Elifa58/Arduino_Uno_PCB/PCB_Project.pdf

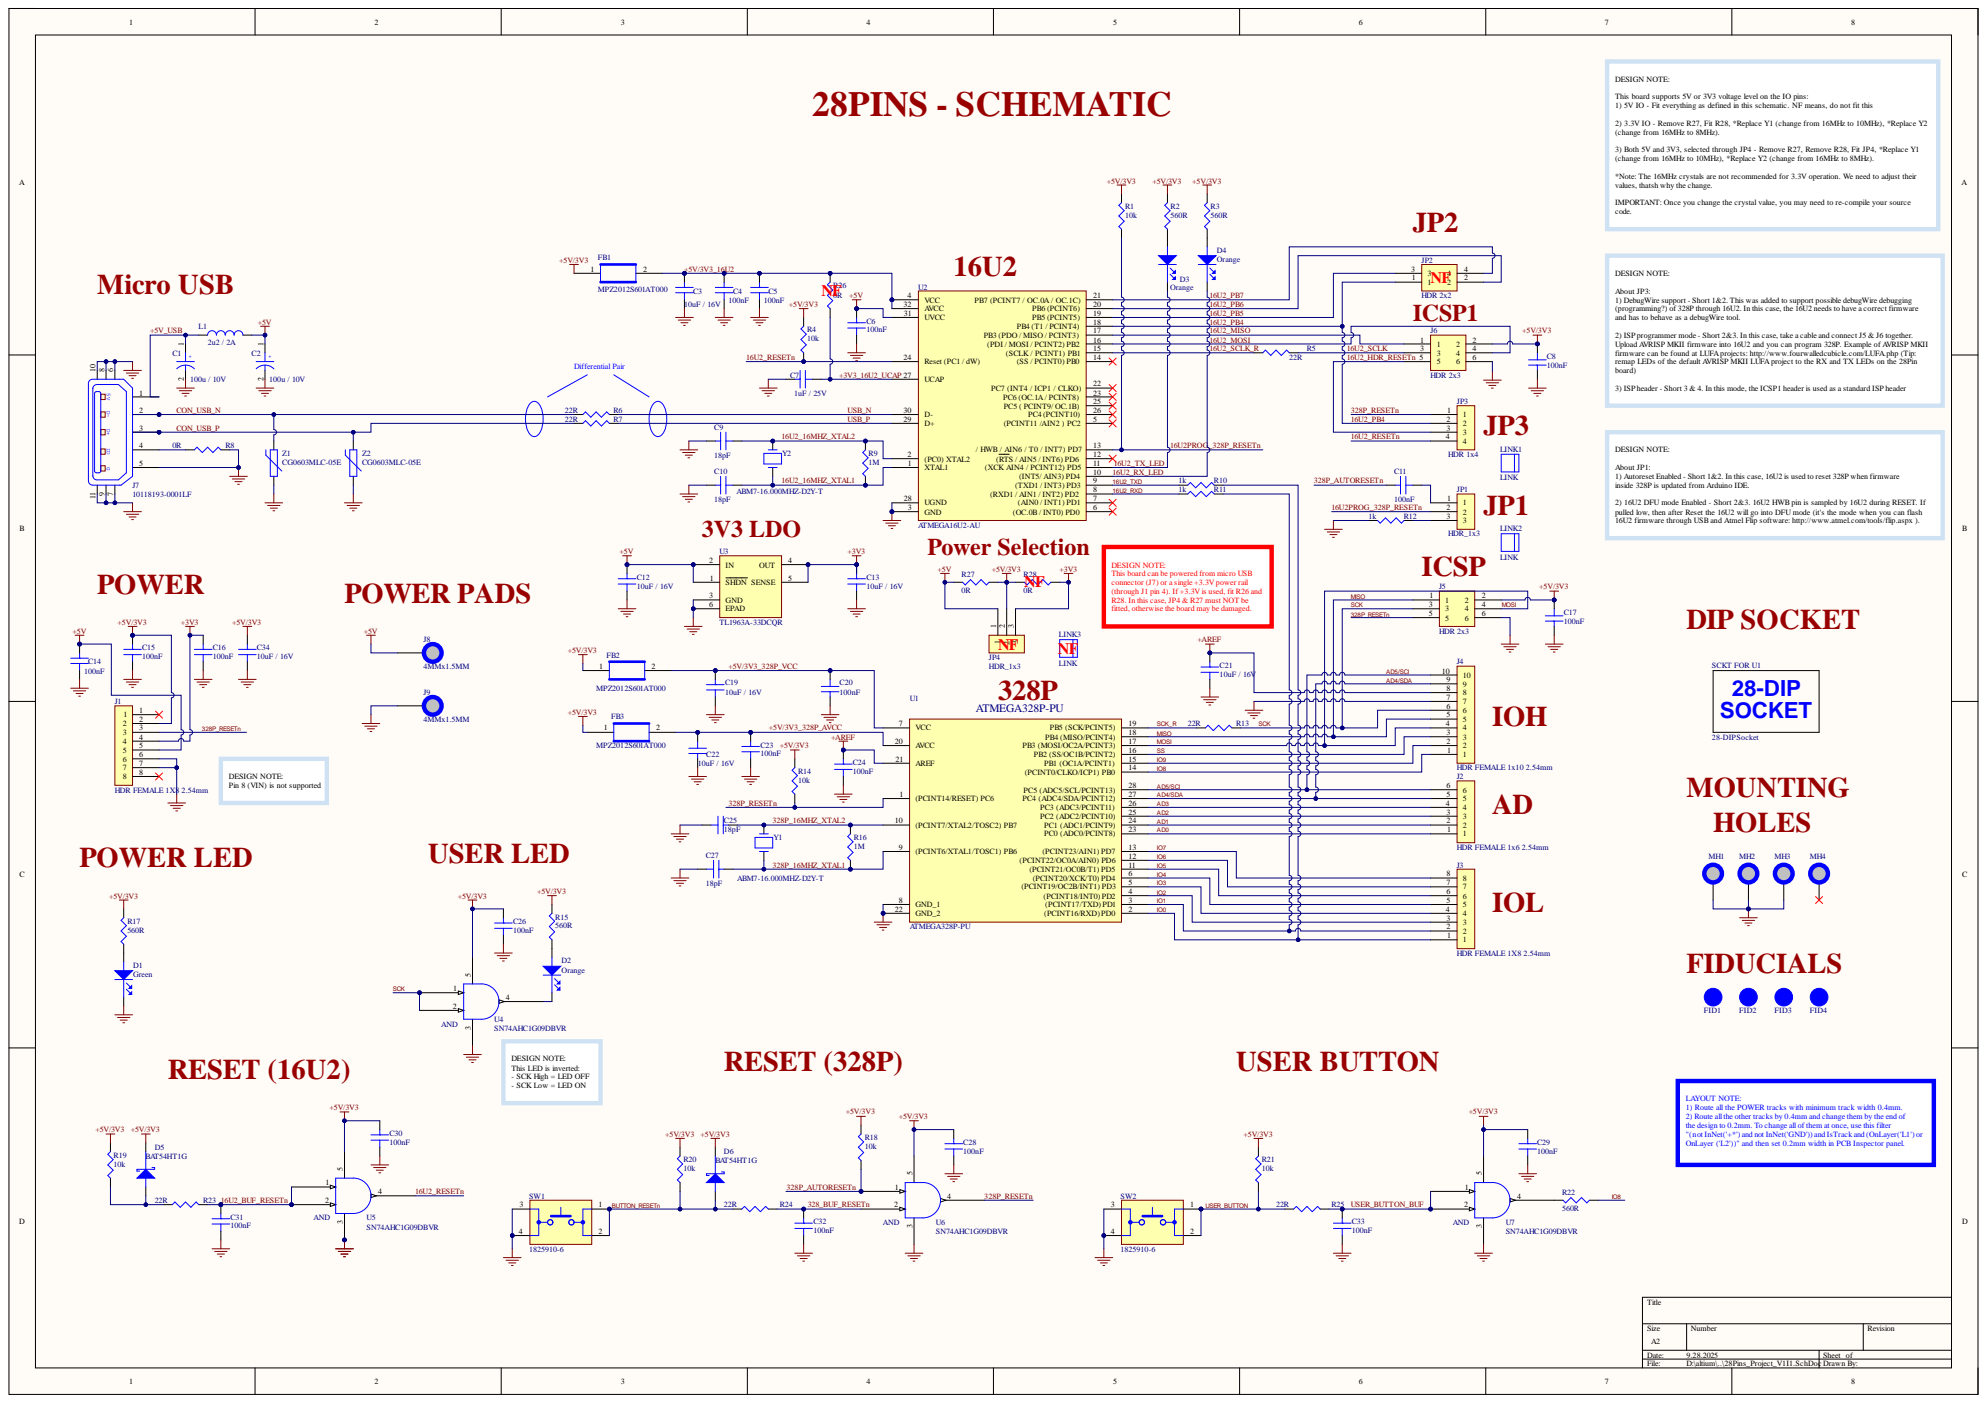
[picture p1: page 1]

This board supports 5V or 3V3 voltage level on the IO pins:
1) 5V IO - Fit everything as defined in this schematic. NF means, do not fit this

2) 3.3V IO - Remove R27, Fit R28, *Replace Y1 (change from 16MHz to 10MHz), *Replace Y2
(change from 16MHz to 8MHz).

3) Both 5V and 3V3, selected through JP4 - Remove R27, Remove R28, Fit JP4, *Replace Y1
(change from 16MHz to 10MHz), *Replace Y2 (change from 16MHz to 8MHz).

*Note: The 16MHz crystals are not recommended for 3.3V operation. We need to adjust their
values, thatsh why the change.

IMPORTANT: Once you change the crystal value, you may need to re-compile your source
code.

Orange 16U2_PB7

About JP3:
1) DebugWire support - Short 1&2. This was added to support possible debugWire debugging
(programming?) of 328P through 16U2. In this case, the 16U2 needs to have a correct firmware
and has to behave as a debugWire tool.

UVCC 31 AVCC 32 | 16U2_PB6 | ICSP1

2) ISP programmer mode - Short 2&3. In this case, take a cable and connect J5 & J6 together.
Upload AVRISP MKII firmware into 16U2 and you can program 328P. Example of AVRISP MKII
firmware can be found at LUFAprojects: http://www.fourwalledcubicle.com/LUFA.php (Tip:
remap LEDs of the default AVRISP MKII LUFAproject to the RX and TX LEDs on the 28Pin
board)

3) ISP header - Short 3 & 4. In this mode, the ICSP1 header is used as a standard ISP header

About JP1:
1) Autoreset Enabled - Short 1&2. In this case, 16U2 is used to reset 328P when firmware
inside 328P is updated from Arduino IDE.

2) 16U2 DFU mode Enabled - Short 2&3. 16U2 HWB pin is sampled by 16U2 during RESET. If
pulled low, then after Reset the 16U2 will go into DFU mode (it's the mode when you can flash
16U2 firmware through USB and Atmel Flip software: http://www.atmel.com/tools/flip.aspx ).

DESIGN NOTE:
This board can be powered from micro USB
connector (J7) or a single +3.3V power rail
(through J1 pin 4). If +3.3V is used, fit R26 and
R28. In this case, JP4 & R27 must NOT be
fitted, otherwise the board may be damaged.

Pin 8 (VIN) is not supported

(PCINT6/XTAL1/TOSC1) PB6 9 | AD0

IO5
IO4
IO3

GND_2 22 | | IO0

This LED is inverted:
- SCK High = LED OFF
- SCK Low = LED ON

LAYOUT NOTE:
1) Route all the POWER tracks with minimum track width 0.4mm.
2) Route all the other tracks by 0.4mm and change them by the end of
the design to 0.2mm. To change all of them at once, use this filter
"(not InNet('+*') and not InNet('GND')) and IsTrack and (OnLayer('L1') or
OnLayer ('L2'))" and then set 0.2mm width in PCB Inspector panel.

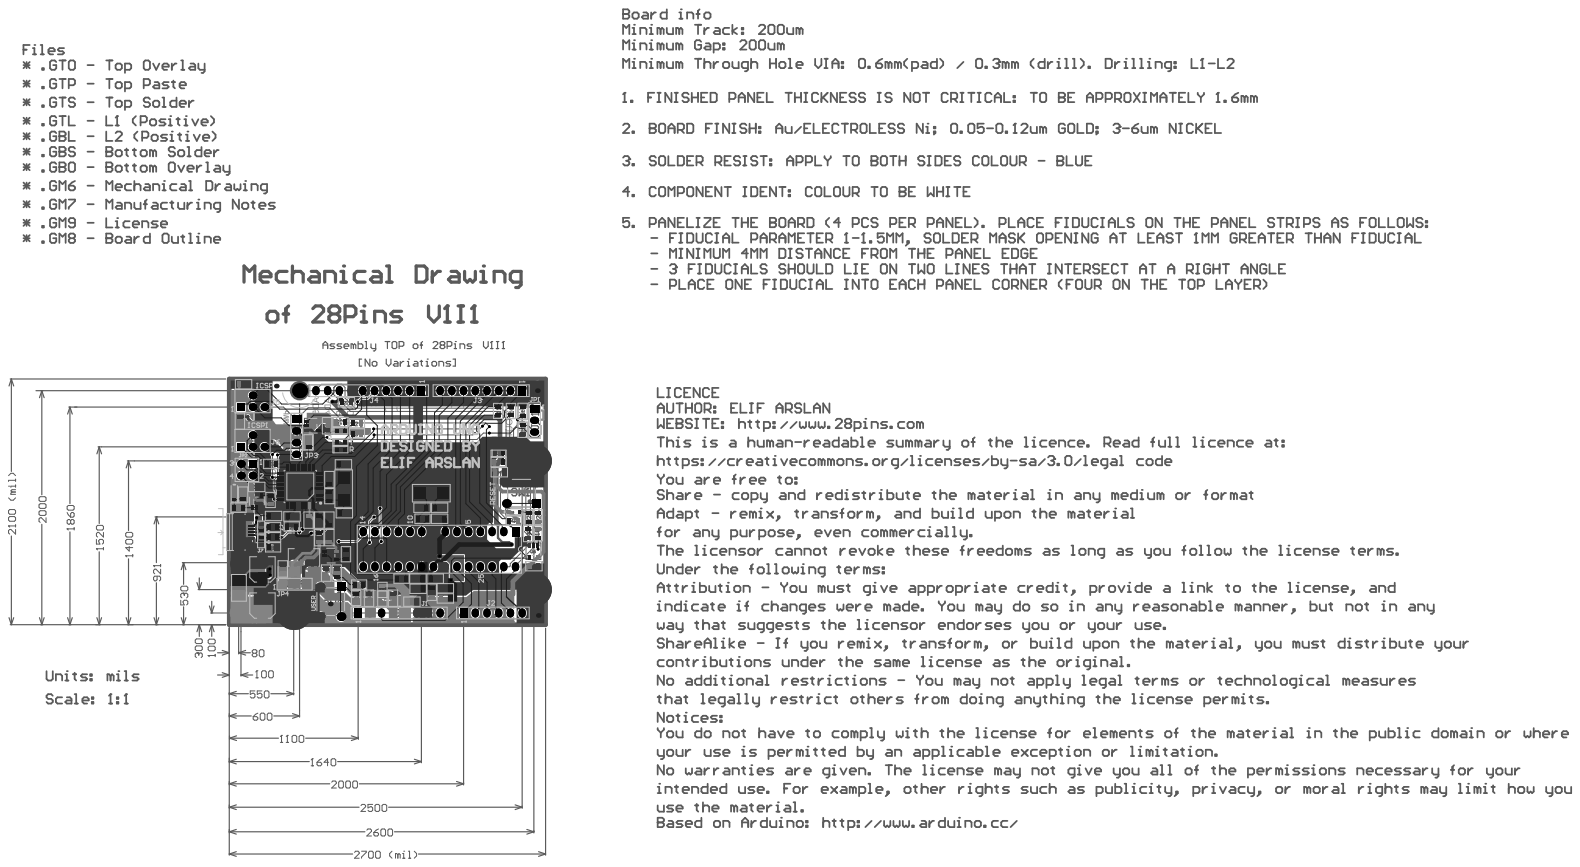
[picture p2: page 2]

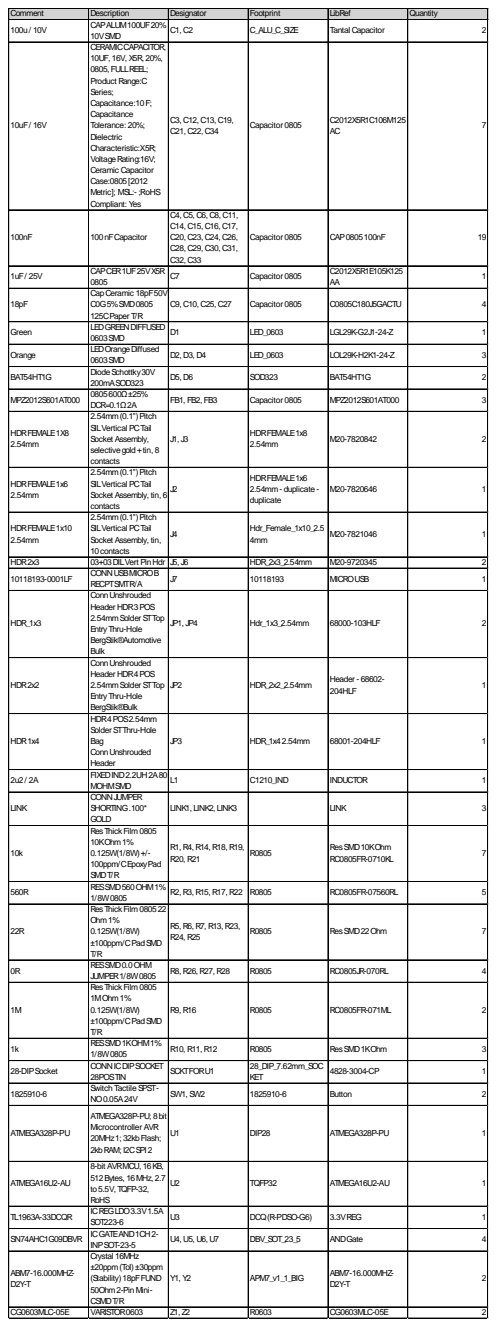
[picture p3: page 3]

Comment | Description | Designator | Footprint | LibRef | Quantity
100u/ 10V | CAPALUM100UF20% 10VSMD | C1, C2 | C_ALU_C_SIZE | Tantal Capacitor | | 2

10uF/ 16V | CERAMICCAPACITOR, 10UF, 16V, X5R, 20%, 0805, FULLREEL; Product Range:C Series; Capacitance:10F; Capacitance Tolerance: 20%; Dielectric Characteristic:X5R; VoltageRating:16V; Ceramic Capacitor Case:0805[2012 Metric]; MSL:- ;RoHS Compliant: Yes | C3, C12, C13, C19, C21, C22, C34 | Capacitor 0805 | C2012X5R1C106M125 AC | | 7

100nF | 100nFCapacitor | C4, C5, C6, C8, C11, C14, C15, C16, C17, C20, C23, C24, C26, C28, C29, C30, C31, C32, C33 | Capacitor 0805 | CAP0805100nF | 19

1uF/ 25V | CAPCER1UF25VX5R 0805 | C7 | Capacitor 0805 | C2012X5R1E105K125 AA | | 1

18pF | CapCeramic 18pF50V C0G5%SMD0805 125CPaper T/R | C9, C10, C25, C27 | Capacitor 0805 | C0805C180J5GACTU | | 4

Green | LEDGREENDIFFUSED 0603SMD | D1 | LED_0603 | LGL29K-G2J1-24-Z | | 1

Orange | LEDOrangeDiffused 0603SMD | D2, D3, D4 | LED_0603 | LOL29K-H2K1-24-Z | | 3

BAT54HT1G | DiodeSchottky30V 200mASOD323 | D5, D6 | SOD323 | BAT54HT1G | | 2

MPZ2012S601AT000 | 0805600Ω±25% DCR=0.1Ω2A | FB1, FB2, FB3 | Capacitor 0805 | MPZ2012S601AT000 | | 3

HDRFEMALE1X8 2.54mm | 2.54mm(0.1")Pitch SILVertical PCTail Socket Assembly, selectivegold+tin, 8 contacts | J1, J3 | HDRFEMALE1x8 2.54mm | M20-7820842 | | 2

HDRFEMALE1x6 2.54mm | 2.54mm(0.1")Pitch SILVertical PCTail Socket Assembly, tin, 6 contacts | J2 | HDRFEMALE1x6 2.54mm- duplicate-duplicate | M20-7820646 | | 1

HDRFEMALE1x10 2.54mm | 2.54mm(0.1")Pitch SILVertical PCTail Socket Assembly, tin, 10contacts | J4 | Hdr_Female_1x10_2.5 4mm | M20-7821046 | | 1

HDR2x3 | 03+03DILVert PinHdr | J5, J6 | HDR_2x3_2.54mm | M20-9720345 | | 2
10118193-0001LF | CONNUSBMICROB RECPTSMTR/A | J7 | 10118193 | MICROUSB | | 1

HDR_1x3 | ConnUnshrouded Header HDR3POS 2.54mmSolder STTop EntryThru-Hole BergStik®Automotive Bulk | JP1, JP4 | Hdr_1x3_2.54mm | 68000-103HLF | | 2

HDR2x2 | ConnUnshrouded Header HDR4POS 2.54mmSolder STTop EntryThru-Hole BergStik®Bulk | JP2 | HDR_2x2_2.54mm | Header - 68602-204HLF | | 1

HDR1x4 | HDR4POS2.54mm Solder STThru-Hole Bag ConnUnshrouded Header | JP3 | HDR_1x42.54mm | 68001-204HLF | | 1

2u2/ 2A | FIXEDIND2.2UH2A80 MOHMSMD | L1 | C1210_IND | INDUCTOR | | 1

LINK | CONNJUMPER SHORTING.100* GOLD | LINK1, LINK2, LINK3 | | LINK | | 3

10k | ResThickFilm 0805 10KOhm1% 0.125W(1/8W)+/-100ppm/CEpoxyPad SMDT/R | R1, R4, R14, R18, R19, R20, R21 | R0805 | ResSMD10KOhm RC0805FR-0710KL | | 7

560R | RESSMD560OHM1% 1/8W0805 | R2, R3, R15, R17, R22 | R0805 | RC0805FR-07560RL | | 5

22R | ResThickFilm 080522 Ohm1% 0.125W(1/8W) ±100ppm/CPadSMD T/R | R5, R6, R7, R13, R23, R24, R25 | R0805 | ResSMD22Ohm | | 7

0R | RESSMD0.0OHM JUMPER1/8W0805 | R8, R26, R27, R28 | R0805 | RC0805JR-070RL | | 4

1M | ResThickFilm 0805 1MOhm1% 0.125W(1/8W) ±100ppm/CPadSMD T/R | R9, R16 | R0805 | RC0805FR-071ML | | 2

1k | RESSMD1KOHM1% 1/8W0805 | R10, R11, R12 | R0805 | ResSMD1KOhm | | 3

28-DIPSocket | CONNICDIPSOCKET 28POSTIN | SCKTFORU1 | 28_DIP_7.62mm_SOC KET | 4828-3004-CP | | 1

1825910-6 | SwitchTactileSPST-NO0.05A24V | SW1, SW2 | 1825910-6 | Button | | 2

ATMEGA328P-PU | ATMEGA328P-PU; 8bit Microcontroller AVR 20MHz1; 32kbFlash; 2kbRAM; I2CSPI2 | U1 | DIP28 | ATMEGA328P-PU | | 1

ATMEGA16U2-AU | 8-bit AVRMCU, 16KB, 512Bytes, 16MHz, 2.7 to5.5V, TQFP-32, RoHS | U2 | TQFP32 | ATMEGA16U2-AU | | 1

TL1963A-33DCQR | ICREGLDO3.3V1.5A SOT223-6 | U3 | DCQ(R-PDSO-G6) | 3.3VREG | | 1

SN74AHC1G09DBVR | ICGATEAND1CH2-INPSOT-23-5 | U4, U5, U6, U7 | DBV_SOT_23_5 | ANDGate | | 4

ABM7-16.000MHZ-D2Y-T | Crystal 16MHz ±20ppm(Tol) ±30ppm (Stability)18pFFUND 50Ohm2-PinMini-CSMDT/R | Y1, Y2 | APM7_v1_1_BIG | ABM7-16.000MHZ-D2Y-T | | 2

CG0603MLC-05E | VARISTOR0603 | Z1, Z2 | R0603 | CG0603MLC-05E | | 2
