Elifa58/Arduino_Uno_PCB/(list of files, drawings)

Other design files:
28Pins_Project_V1I1.PcbLib
28Pins_Project_V1I1.SchDoc
28Pins_Project_V1I1.SchLib
PCB_Project.PrjPcb
